brico-labs/telares/README.md

Introducción
============

Un poco de rollo.
