brico-labs/telares/doc/src/000_preamble.md

---
title: Telares
author:
- Sergio Alvariño <salvari@gmail.com>
tags: [Telares]
date: enero-2019
lang: es-ES
abstract: |
  Recopilando planos de telares
---
