brico-labs/telares/doc/out/telares.pdf

## Telares

Sergio Alvariño salvari@gmail.com

enero-2019

Resumen

Recopilando planos de telares

### Índice general

1 Introducción | 1

### 1 Introducción

Un poco de rollo.

1
