brico-labs/telares/freecad/telar_meinolf.fcstd

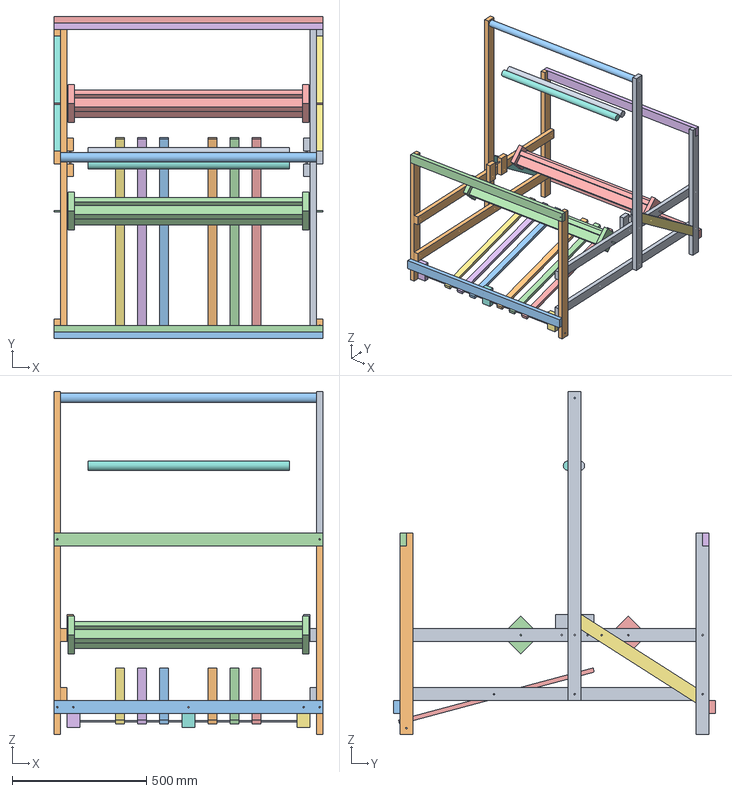
[picture p12: CAD file, 2019-01-09]
freecad/telar_meinolf.fcstd
1000.0 x 1198.0 x 1276.0 mm
lateral_r
lateral_l
frontbar_d
frontbar_u
rearbar_d
rearbar_u
brace_r
brace_l
pivot_r
pivot_l
lam_bridge
lam_front
lam_back
pedal_rod_l
pedal_rod_r
pedal_rod_c
pedal_rod
pedal_1r
pedal_1l
pedal_2r
pedal_3r
pedal_2l
pedal_3l
lam_sf
lam_sr
Beater_l
