brico-labs/telares/(commit log)

2019-01-09 Primer commit
    Añade estructura de documentación
    Añade fichero freecad del telar_meinholf (sin terminar)
    [telar_meinolf.fcstd]
2019-05-26 Engade o pdf de instruccións tear meinolf
